CCHS-Melbourne/dingo-cap/v1.4.3d.back.png

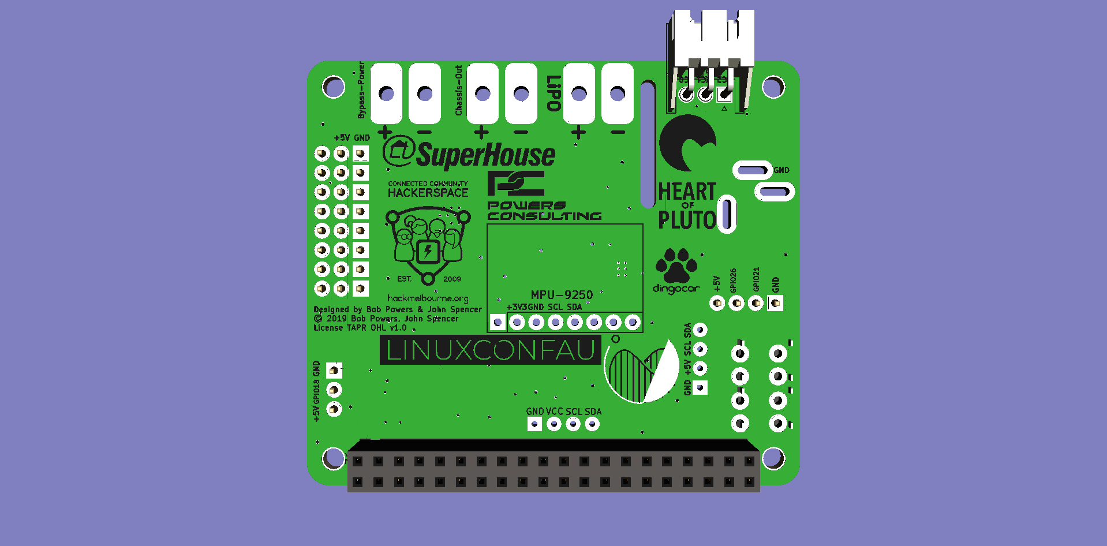
v1.4.3d.back.png
