CCHS-Melbourne/dingo-cap/v1.4.3d.front.png

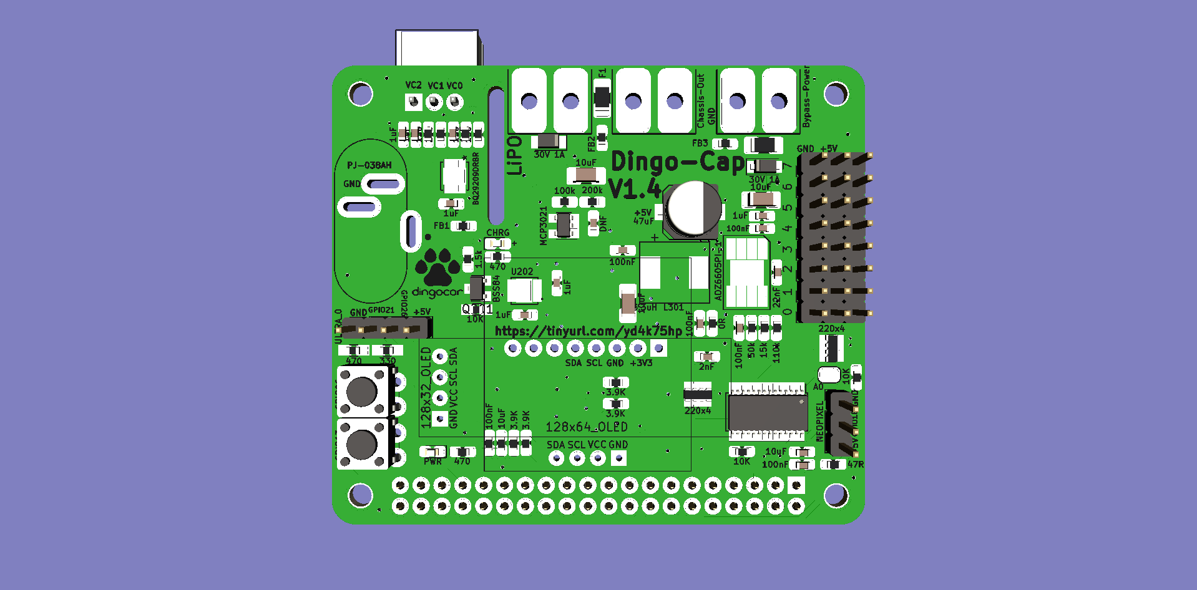
v1.4.3d.front.png
