CCHS-Melbourne/dingo-cap/Models/ElecCap.Panasonic.6.3 SIZE CODE D8.stp

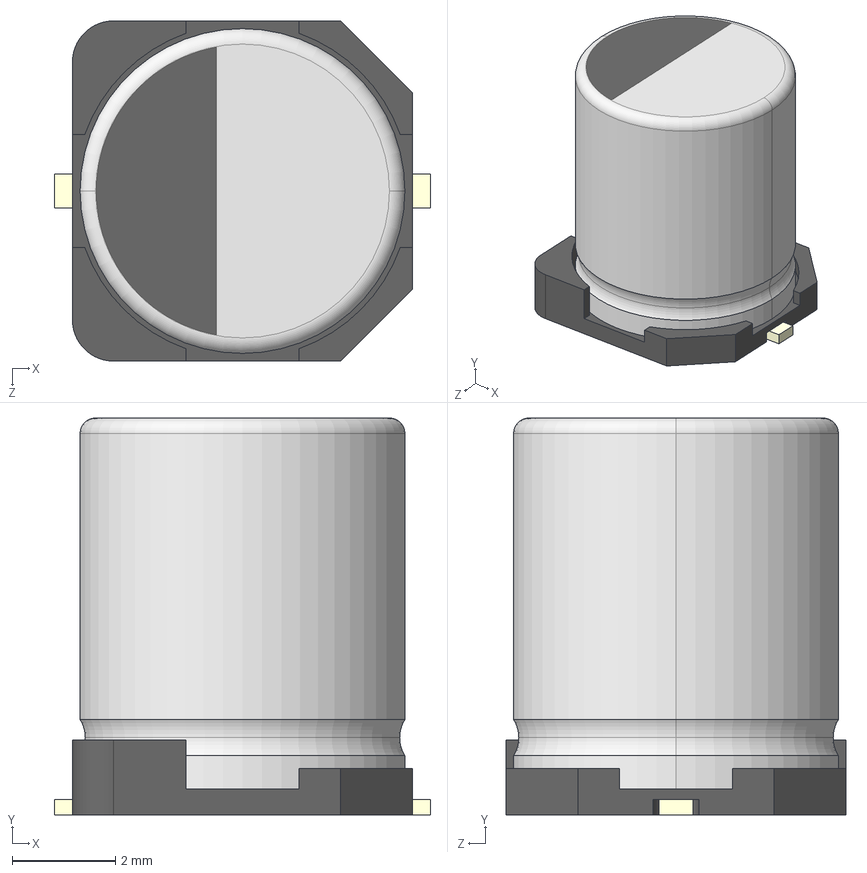
[picture p3: CAD file, 2019-10-31]
Models/ElecCap.Panasonic.6.3 SIZE CODE D8.stp
7.30 x 7.70 x 6.60 mm
標準SIZE CODE D8-001
標準SIZE CODE D8-002
標準SIZE CODE D8-003 x 2
