CCHS-Melbourne/dingo-cap/Models/Inductor.MPLCH0740L3R3.step

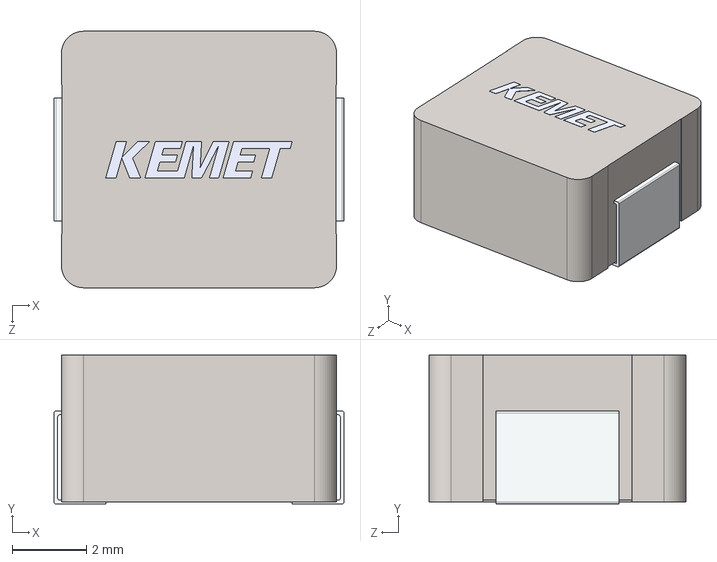
[picture p4: CAD file, 2019-10-31]
Models/Inductor.MPLCH0740L3R3.step
7.80 x 4.00 x 6.90 mm
