CCHS-Melbourne/dingo-cap/Models/ProtIC.SON60P300X60_HS-7N.step

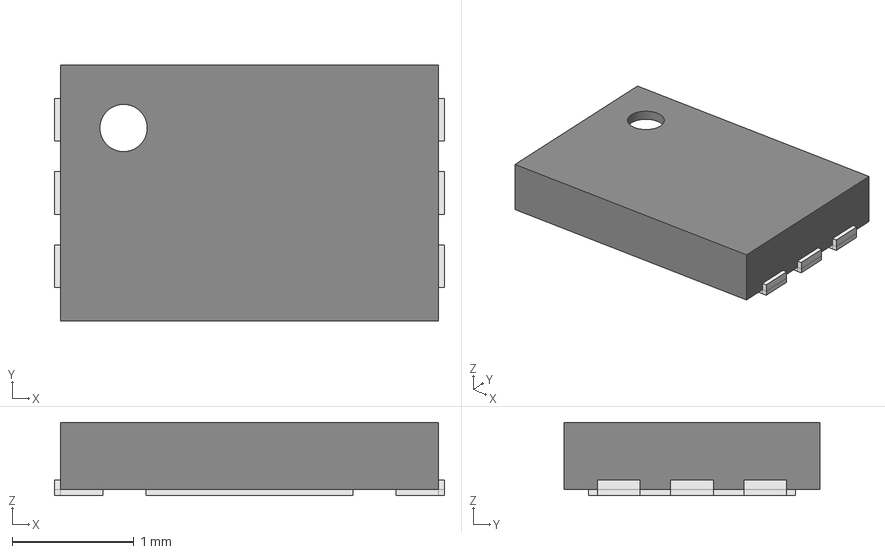
[picture p5: CAD file, 2019-10-31]
Models/ProtIC.SON60P300X60_HS-7N.step
3.20 x 2.10 x 0.6 mm
Open_CASCADE_STEP_translator_6.8_8.1
Open_CASCADE_STEP_translator_6.8_8.2.1
Thermal_Shape
Open_CASCADE_STEP_translator_6.8_8.4.1 x 6
