CCHS-Melbourne/dingo-cap/Models/DCDC.SOIC127P600-8N.step

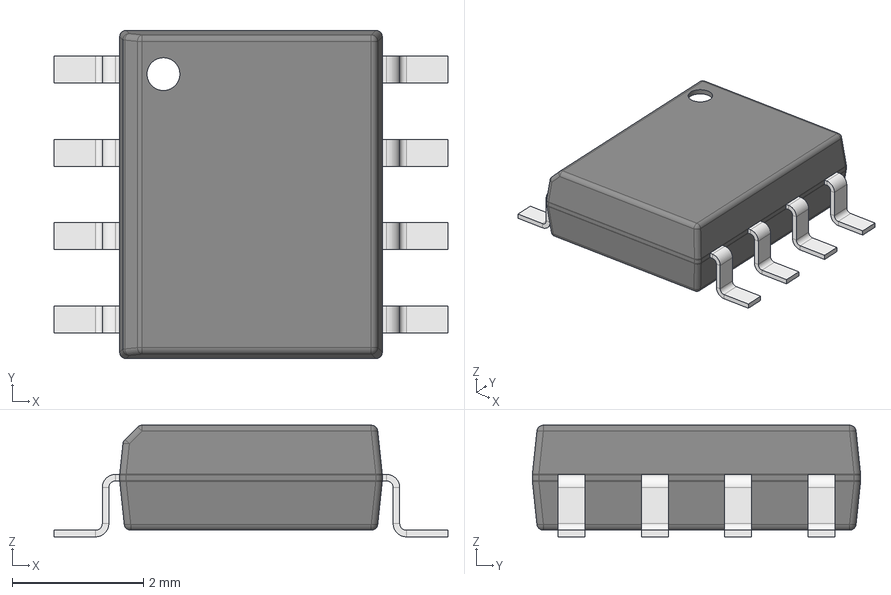
[picture p6: CAD file, 2019-10-31]
Models/DCDC.SOIC127P600-8N.step
6.00 x 5.00 x 1.70 mm
Open_CASCADE_STEP_translator_6.8_5.1
Open_CASCADE_STEP_translator_6.8_5.2.1
Leader x 8
