CCHS-Melbourne/dingo-cap/Models/Barrel.Jack.CUI_PJ-037B.step

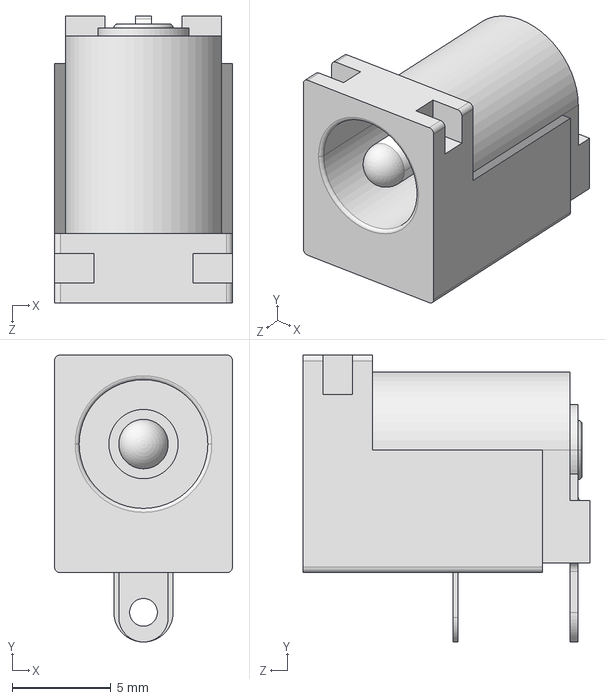
[picture p7: CAD file, 2019-10-31]
Models/Barrel.Jack.CUI_PJ-037B.step
9.00 x 14.5 x 14.5 mm
