CCHS-Melbourne/dingo-cap/pdf/dingo-hat.1.0.pdf

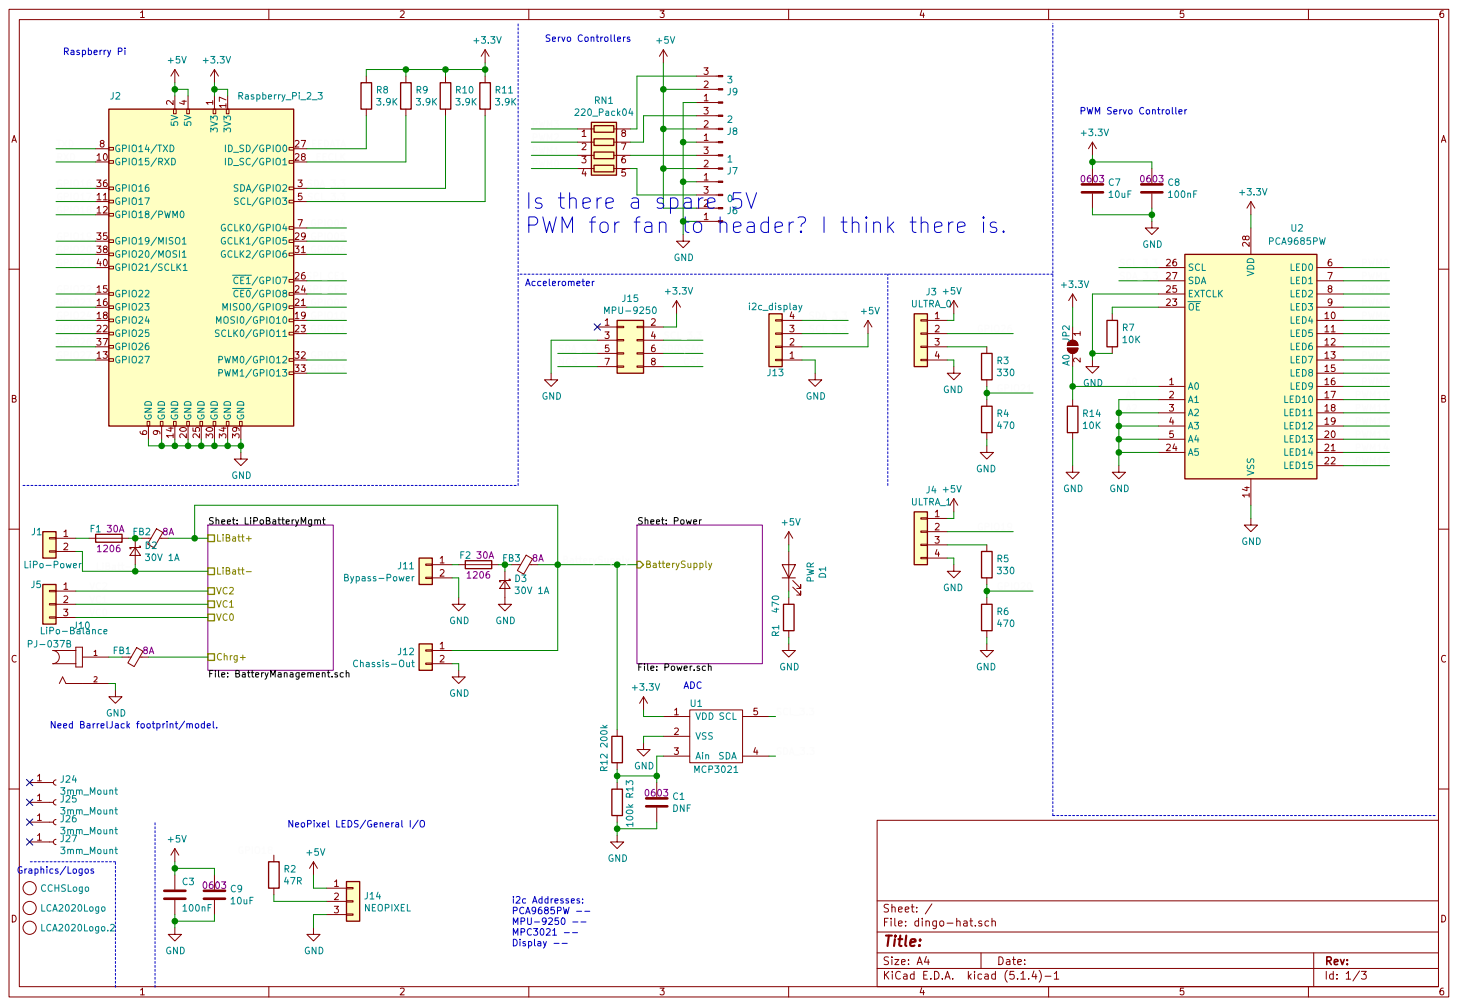
[picture p8: page 1]

File: dingo-hat.sch Sheet: / Sheet: Power File: Power.sch BatterySupply

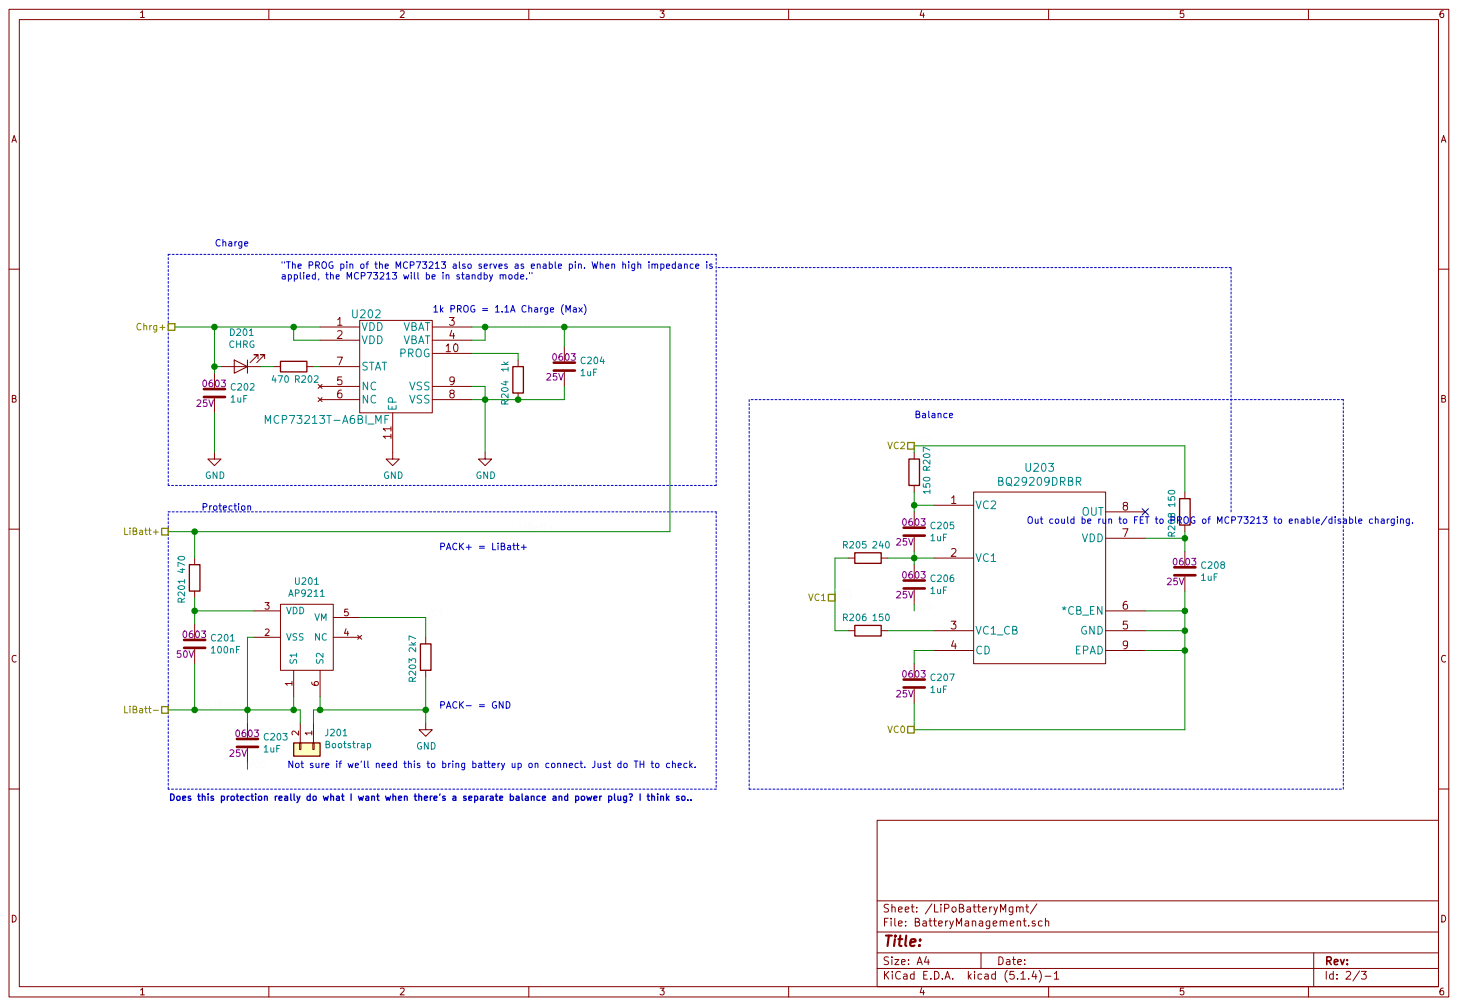
[picture p9: page 2]

"The PROG pin of the MCP73213 also serves as enable pin. When high impedance is
applied, the MCP73213 will be in standby mode."

LiBatt+

1 VSS 2 VDD 3 NC 4 VM 5 S2

Does this protection really do what I want when there's a separate balance and power plug? I think so.. PACK- = GND

Not sure if we'll need this to bring battery up on connect. Just do TH to check.

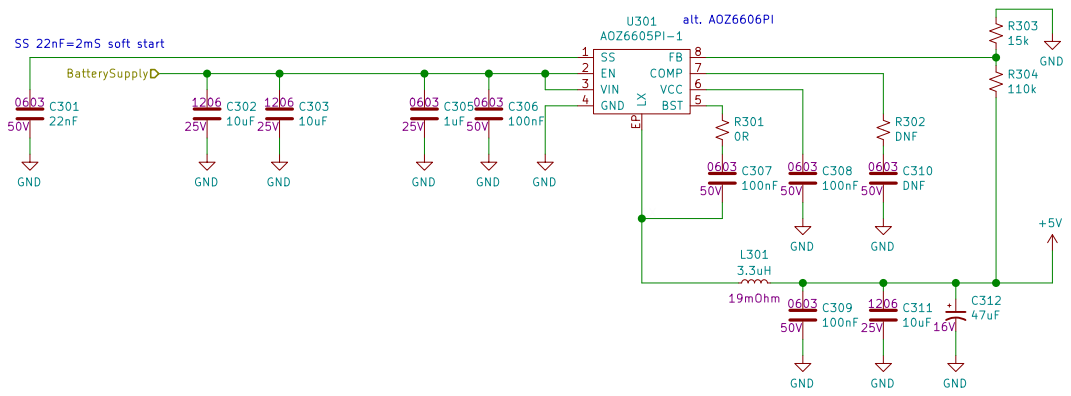
[picture p10: page 3]

alt. AOZ6606PI SS 22nF=2mS soft start

Id: 3/3 Title: File: Power.sch Sheet: /Power/ GND
