CCHS-Melbourne/dingo-cap/dingo-hat.kicad_pcb

## KiCad design dingo-hat.kicad_pcb (2019-12-08)

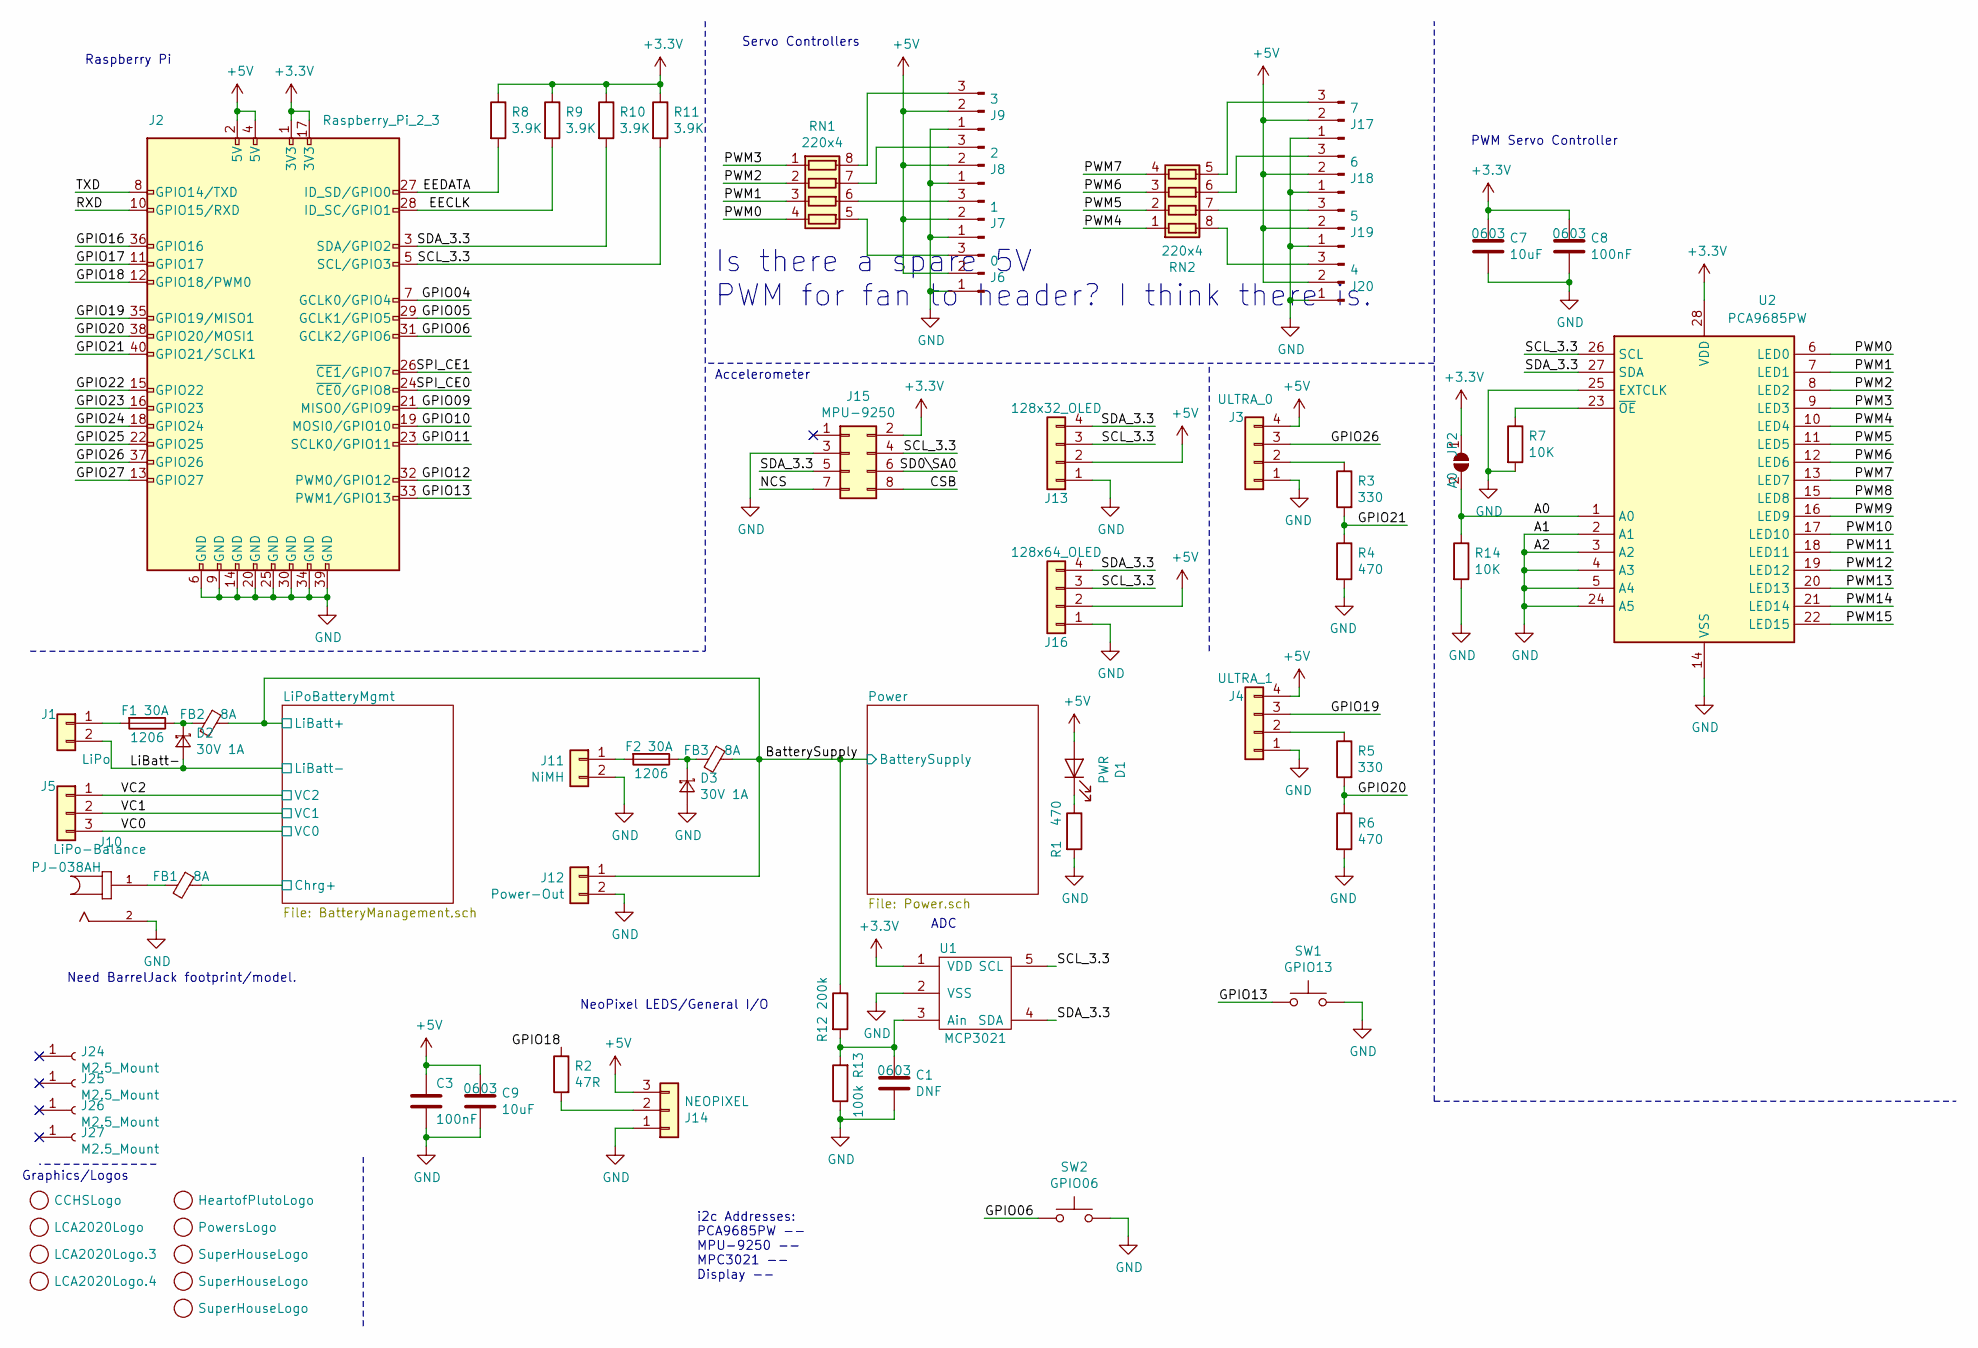
[picture p11: schematic dingo-hat.sch]

Parts:
C1: DNF; C_0603_1608Metric_Pad1.05x0.95mm_HandSolder; Voltage Rating 50V
C3: 100nF; R_0603_1608Metric_Pad1.05x0.95mm_HandSolder; Voltage Rating 50V
C7: 10uF; C_0603_1608Metric_Pad1.05x0.95mm_HandSolder
C8: 100nF; C_0603_1608Metric_Pad1.05x0.95mm_HandSolder; Voltage Rating 50V
C9: 10uF; R_0603_1608Metric_Pad1.05x0.95mm_HandSolder
D1: PWR; LED_0603_1608Metric_Pad1.05x0.95mm_HandSolder
D2, D3: 30V 1A; D_SOD-123F; Voltage Rating 30V
F1, F2: Fuse; R_1206_3216Metric_Pad1.42x1.75mm_HandSolder; Voltage Rating 32V
FB1, FB2, FB3: Ferrite_Bead_Small; R_0603_1608Metric_Pad1.05x0.95mm_HandSolder
G1: CCHSLogo; logo.cchs
G2: LCA2020Logo; logo.LCA.2020.1
G3: HeartofPlutoLogo; logo.HeartOfPluto2
G4: LCA2020Logo.3; logo-2020.silk
G5: LCA2020Logo.4; logo-2020.mask
G6: PowersLogo; logo.pc
G7: SuperHouseLogo; logo.superhouse
G8, G9: SuperHouseLogo; logo.dingocar
J1: LiPo; SolderWirePad_2x_5.08mm_14-18AWG-2mmDrill
J2: Raspberry_Pi_2_3; PinSocket_2x20_P2.54mm_Vertical
J3: ULTRA_0; Pin_Header_Straight_1x04_Pitch2.54mm
J4: ULTRA_1; Pin_Header_Straight_1x04_Pitch2.54mm
J5: LiPo-Balance; JST_XH_S03B-XH-A_03x2.50mm_Angled
J6: 0; PinHeader_1x03_P2.54mm_Vertical
J7: 1; PinHeader_1x03_P2.54mm_Vertical
J8: 2; PinHeader_1x03_P2.54mm_Vertical
J9: 3; PinHeader_1x03_P2.54mm_Vertical
J10: PJ-038AH; CUI_PJ-038AH; Mfg Part # PJ-038AH
J11: NiMH; SolderWirePad_2x_5.08mm_14-18AWG-2mmDrill
J12: Power-Out; SolderWirePad_2x_5.08mm_14-18AWG-2mmDrill
J13: 128x32_OLED; 0.91 OLED
J14: NEOPIXEL; PinHeader_1x03_P2.54mm_Vertical
J15: MPU-9250; PinHeader_1x08_P2.54mm_Vertical
J16: 128x64_OLED
J17: 7; PinHeader_1x03_P2.54mm_Vertical
J18: 6; PinHeader_1x03_P2.54mm_Vertical
J19: 5; PinHeader_1x03_P2.54mm_Vertical
J20: 4; PinHeader_1x03_P2.54mm_Vertical
J24, J25, J26, J27: M2.5_Mount; MountingHole_2.7mm_M2.5
JP2: A0; SolderJumper-2_P1.3mm_Open_RoundedPad1.0x1.5mm
R1: 470; R_0603_1608Metric_Pad1.05x0.95mm_HandSolder
R2: 47R; R_0603_1608Metric_Pad1.05x0.95mm_HandSolder
R3, R5: 330; R_0603_HandSoldering
R4, R6: 470; R_0603_HandSoldering
R7, R14: 10K; R_0603_1608Metric_Pad1.05x0.95mm_HandSolder
R8, R9, R10, R11: 3.9K; R_0603_1608Metric_Pad1.05x0.95mm_HandSolder
R12: 200k; R_0603_1608Metric_Pad1.05x0.95mm_HandSolder
R13: 100k; R_0603_1608Metric_Pad1.05x0.95mm_HandSolder
RN1, RN2: 220x4; R_Array_Convex_4x0603
SW1: GPIO13; SW_PUSH_4.5mm
SW2: GPIO06; SW_PUSH_4.5mm
U1: MCP3021; SOT-23-5; Mfg Part # MCP3021A5T-E/OT
U2: PCA9685PW; TSSOP-28_4.4x9.7mm_P0.65mm; Mfg Part # PCA9685

Connections:
+3V3: C7.1, C8.1, J2.1 (3V3), J2.17 (3V3), J15.2, JP2.1 (A), R8.1, R9.1, R10.1, R11.1, U1.1 (VDD), U2.28 (VDD)
+5V: C3.1, C9.1, D1.2 (A), J2.2 (5V), J2.4 (5V), J3.4, J4.4, J6.2, J7.2, J8.2, J9.2, J13.2, J14.3, J16.2, J17.2, J18.2, J19.2, J20.2; also elsewhere on the board
/A0: JP2.2 (B), R14.1, U2.1 (A0)
/BatterySupply: FB2.1, FB3.1, J12.1, R12.1; also elsewhere on the board
/CSB: J15.8
/EECLK: J2.28 (ID_SC/GPIO1), R9.2
/EEDATA: J2.27 (ID_SD/GPIO0), R8.2
/GPIO04: J2.7 (GCLK0/GPIO4)
/GPIO05: J2.29 (GCLK1/GPIO5)
/GPIO06: J2.31 (GCLK2/GPIO6), SW2.1
/GPIO09: J2.21 (MISO0/GPIO9)
/GPIO10: J2.19 (MOSI0/GPIO10)
/GPIO11: J2.23 (SCLK0/GPIO11)
/GPIO12: J2.32 (PWM0/GPIO12)
/GPIO13: J2.33 (PWM1/GPIO13), SW1.1
/GPIO16: J2.36 (GPIO16)
/GPIO17: J2.11 (GPIO17)
/GPIO18: J2.12 (GPIO18/PWM0), R2.1
/GPIO19: J2.35 (GPIO19/MISO1), J4.3
/GPIO20: J2.38 (GPIO20/MOSI1), R5.2, R6.1
/GPIO21: J2.40 (GPIO21/SCLK1), R3.2, R4.1
/GPIO22: J2.15 (GPIO22)
/GPIO23: J2.16 (GPIO23)
/GPIO24: J2.18 (GPIO24)
/GPIO25: J2.22 (GPIO25)
/GPIO26: J2.37 (GPIO26), J3.3
/GPIO27: J2.13 (GPIO27)
/LiPoBatteryMgmt/Chrg+: FB1.1; also elsewhere on the board
/NCS: J15.7
/PWM0: RN1.4 (R4.1), U2.6 (LED0)
/PWM1: RN1.3 (R3.1), U2.7 (LED1)
/PWM2: RN1.2 (R2.1), U2.8 (LED2)
/PWM3: RN1.1 (R1.1), U2.9 (LED3)
/PWM4: RN2.1 (R1.1), U2.10 (LED4)
/PWM5: RN2.2 (R2.1), U2.11 (LED5)
/PWM6: RN2.3 (R3.1), U2.12 (LED6)
/PWM7: RN2.4 (R4.1), U2.13 (LED7)
/PWM8: U2.15 (LED8)
/PWM9: U2.16 (LED9)
/PWM10: U2.17 (LED10)
/PWM11: U2.18 (LED11)
/PWM12: U2.19 (LED12)
/PWM13: U2.20 (LED13)
/PWM14: U2.21 (LED14)
/PWM15: U2.22 (LED15)
/RXD: J2.10 (GPIO15/RXD)
/SCL_3.3: J2.5 (SCL/GPIO3), J13.3, J15.4, J16.3, R11.2, U1.5 (SCL), U2.26 (SCL)
/SD0\SA0: J15.6
/SDA_3.3: J2.3 (SDA/GPIO2), J13.4, J15.5, J16.4, R10.2, U1.4 (SDA), U2.27 (SDA)
/SPI_CE0: J2.24 (~CE0~/GPIO8)
/SPI_CE1: J2.26 (~CE1~/GPIO7)
/TXD: J2.8 (GPIO14/TXD)
/VC0: J5.3; also elsewhere on the board
/VC1: J5.2; also elsewhere on the board
/VC2: J5.1; also elsewhere on the board
GND: C1.2, C3.2, C7.2, C8.2, C9.2, D2.2 (A), D3.2 (A), J1.2, J2.6 (GND), J2.9 (GND), J2.14 (GND), J2.20 (GND), J2.25 (GND), J2.30 (GND), J2.34 (GND), J2.39 (GND), J3.1, J4.1, J6.1, J7.1, J8.1, J9.1, J10.2, J11.2, J12.2, J13.1, J14.1, J15.3, J16.1, J17.1, J18.1, J19.1, J20.1, R1.2, R4.2, R6.2, R7.2, R13.1, R14.2, SW1.2, SW2.2, U1.2 (VSS), U2.2 (A1), U2.3 (A2), U2.4 (A3), U2.5 (A4), U2.14 (VSS), U2.24 (A5), U2.25 (EXTCLK); also elsewhere on the board
unnamed: C1.1, R12.2, R13.2, U1.3 (Ain)
unnamed: D1.1 (K), R1.1
unnamed: D2.1 (K), F1.1, FB2.2
unnamed: D3.1 (K), F2.1, FB3.2
unnamed: F1.2, J1.1
unnamed: F2.2, J11.1
unnamed: FB1.2, J10.1
unnamed: J3.2, R3.1
unnamed: J4.2, R5.1
unnamed: J6.3, RN1.5 (R4.2)
unnamed: J7.3, RN1.6 (R3.2)
unnamed: J8.3, RN1.7 (R2.2)
unnamed: J9.3, RN1.8 (R1.2)
unnamed: J14.2, R2.2
unnamed: J17.3, RN2.5 (R4.2)
unnamed: J18.3, RN2.6 (R3.2)
unnamed: J19.3, RN2.7 (R2.2)
unnamed: J20.3, RN2.8 (R1.2)
unnamed: R7.1, U2.23 (~OE)

Notes on the sheet:
PWM Servo Controller
NeoPixel LEDS/General I/O
Servo Controllers
Raspberry Pi
Accelerometer
Graphics/Logos
ADC
i2c Addresses: PCA9685PW -- MPU-9250 -- MPC3021 -- Display --
Need BarrelJack footprint/model.
Is there a spare 5V PWM for fan to header? I think there is.

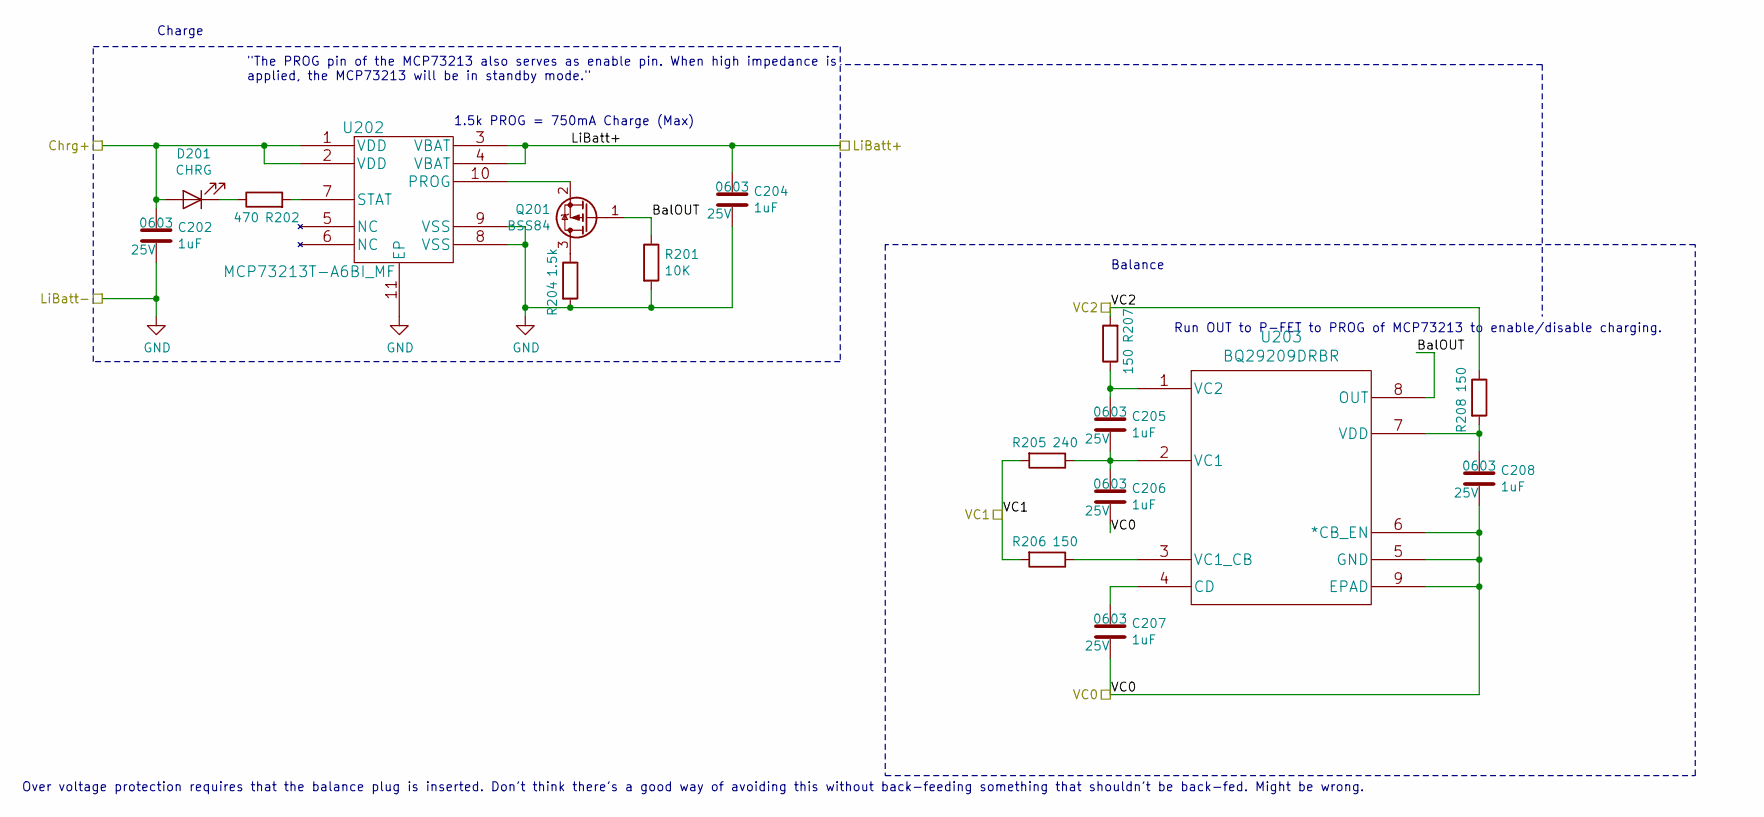
[picture p12: schematic BatteryManagement.sch]

Parts:
C202, C204, C205, C206, C207, C208: 1uF; C_0603_1608Metric_Pad1.05x0.95mm_HandSolder; Voltage Rating 25V
D201: CHRG; LED_0603_1608Metric_Pad1.05x0.95mm_HandSolder
Q201: BSS84; SOT-23
R201: 10K; R_0603_HandSoldering
R202: 470; R_0603_1608Metric_Pad1.05x0.95mm_HandSolder
R204: 1.5k; R_0603_1608Metric_Pad1.05x0.95mm_HandSolder
R205: 240; R_0603_1608Metric_Pad1.05x0.95mm_HandSolder
R206, R207, R208: 150; R_0603_1608Metric_Pad1.05x0.95mm_HandSolder
U202: MCP73213T-A6BI_MF; MCP73213T-A6BI
U203: BQ29209DRBR; Mfg Part # BQ29209DRBR

Connections:
/BatterySupply: C204.1, U202.3 (VBAT), U202.4 (VBAT); also elsewhere on the board
/LiPoBatteryMgmt/BalOUT: Q201.1 (G), R201.1, U203.8 (OUT)
/LiPoBatteryMgmt/Chrg+: C202.1, D201.2 (A), U202.1 (VDD), U202.2 (VDD); also elsewhere on the board
/VC0: C206.2, C207.2, C208.2, U203.5 (GND), U203.6 (*CB_EN), U203.9 (EPAD); also elsewhere on the board
/VC1: R205.2, R206.2; also elsewhere on the board
/VC2: R207.2, R208.1; also elsewhere on the board
GND: C202.2, C204.2, R201.2, R204.2, U202.8 (VSS), U202.9 (VSS), U202.11 (EP); also elsewhere on the board
unnamed: C205.1, R207.1, U203.1 (VC2)
unnamed: C205.2, C206.1, R205.1, U203.2 (VC1)
unnamed: C207.1, U203.4 (CD)
unnamed: C208.1, R208.2, U203.7 (VDD)
unnamed: D201.1 (K), R202.1
unnamed: Q201.2 (S), U202.10 (PROG)
unnamed: Q201.3 (D), R204.1
unnamed: R202.2, U202.7 (STAT)
unnamed: R206.1, U203.3 (VC1_CB)

Notes on the sheet:
1.5k PROG = 750mA Charge (Max)
Run OUT to P-FET to PROG of MCP73213 to enable/disable charging.
Balance
Charge
"The PROG pin of the MCP73213 also serves as enable pin. When high impedance is applied, the MCP73213 will be in standby mode."
Over voltage protection requires that the balance plug is inserted. Don't think there's a good way of avoiding this without back-feeding something that shouldn't be back-fed. Might be wrong.

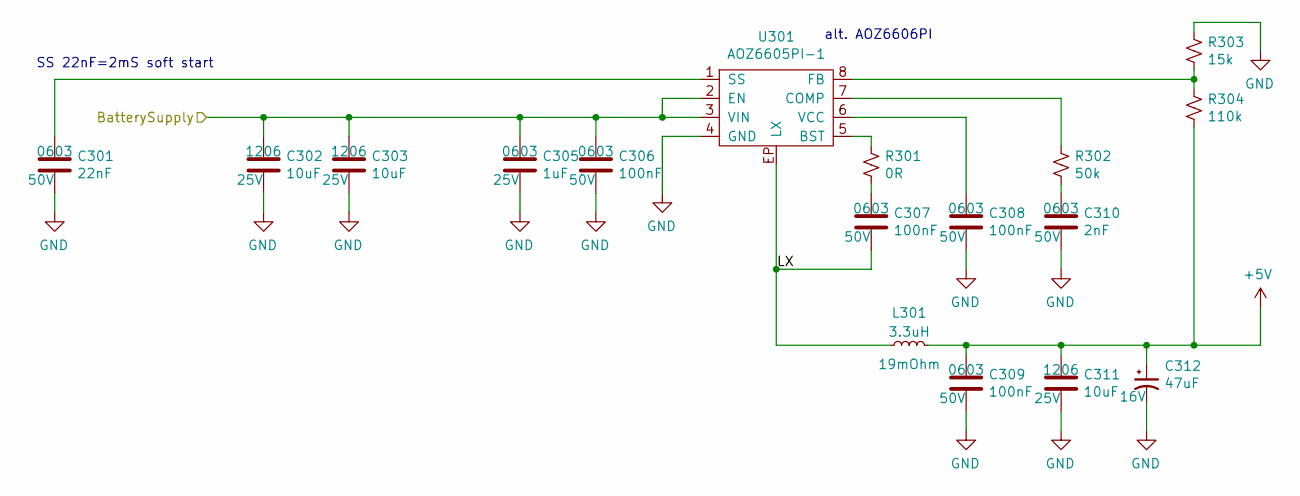
[picture p13: schematic Power.sch]

Parts:
C301: 22nF; C_0603_1608Metric_Pad1.05x0.95mm_HandSolder; Voltage Rating 50V
C302, C303, C311: 10uF; C_1206_3216Metric_Pad1.42x1.75mm_HandSolder; Voltage Rating 25V
C305: 1uF; C_0603_1608Metric_Pad1.05x0.95mm_HandSolder; Voltage Rating 25V
C306, C307, C308, C309: 100nF; C_0603_1608Metric_Pad1.05x0.95mm_HandSolder; Voltage Rating 50V
C310: 2nF; C_0603_1608Metric_Pad1.05x0.95mm_HandSolder; Voltage Rating 50V
C312: 47uF; CP_Elec_6.6x6.6; Voltage Rating 16V
L301: 3.3uH; Inductor-SMT-MPLCH0740
R301: 0R; R_0603_1608Metric_Pad1.05x0.95mm_HandSolder
R302: 50k; R_0603_1608Metric_Pad1.05x0.95mm_HandSolder
R303: 15k; R_0603_1608Metric_Pad1.05x0.95mm_HandSolder
R304: 110k; R_0603_1608Metric_Pad1.05x0.95mm_HandSolder
U301: AOZ6605PI-1; SOIC-8-EP--AOZ6605PI-1; Mfg Part # AOZ6605PI-1

Connections:
+5V: C309.1, C311.1, C312.1, L301.2, R304.2; also elsewhere on the board
/BatterySupply: C302.1, C303.1, C305.1, C306.1, U301.2 (EN), U301.3 (VIN); also elsewhere on the board
/Power/LX: C307.2, L301.1, U301.EP (LX)
GND: C301.2, C302.2, C303.2, C305.2, C306.2, C308.2, C309.2, C310.2, C311.2, C312.2, R303.1, U301.4 (GND); also elsewhere on the board
unnamed: C301.1, U301.1 (SS)
unnamed: C307.1, R301.1
unnamed: C308.1, U301.6 (VCC)
unnamed: C310.1, R302.1
unnamed: R301.2, U301.5 (BST)
unnamed: R302.2, U301.7 (COMP)
unnamed: R303.2, R304.1, U301.8 (FB)

Notes on the sheet:
alt. AOZ6606PI
SS 22nF=2mS soft start

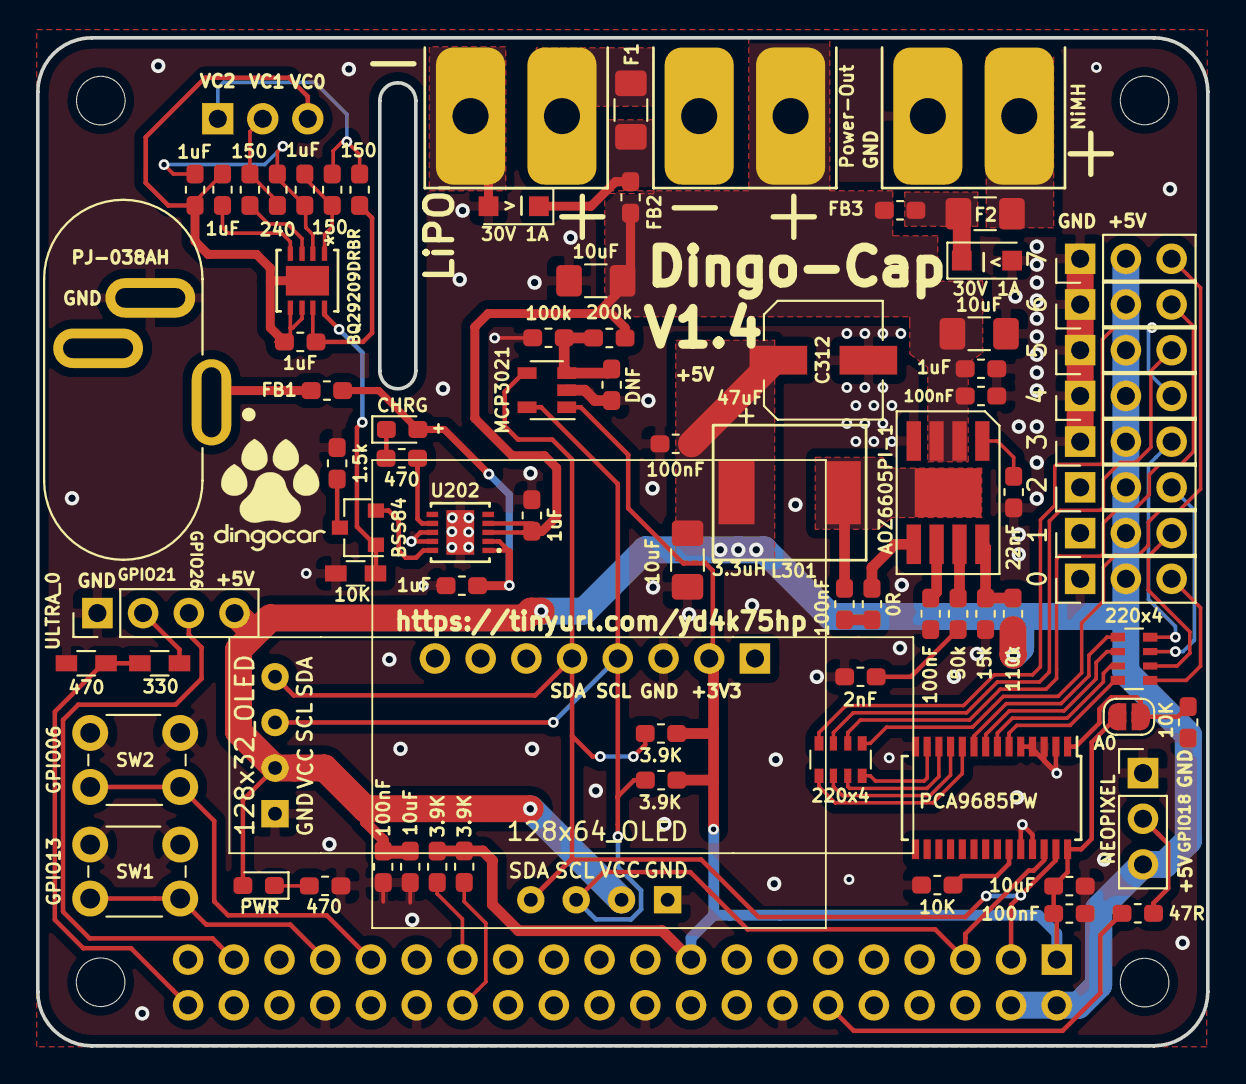
[picture p14: board dingo-hat.kicad_pcb from above]

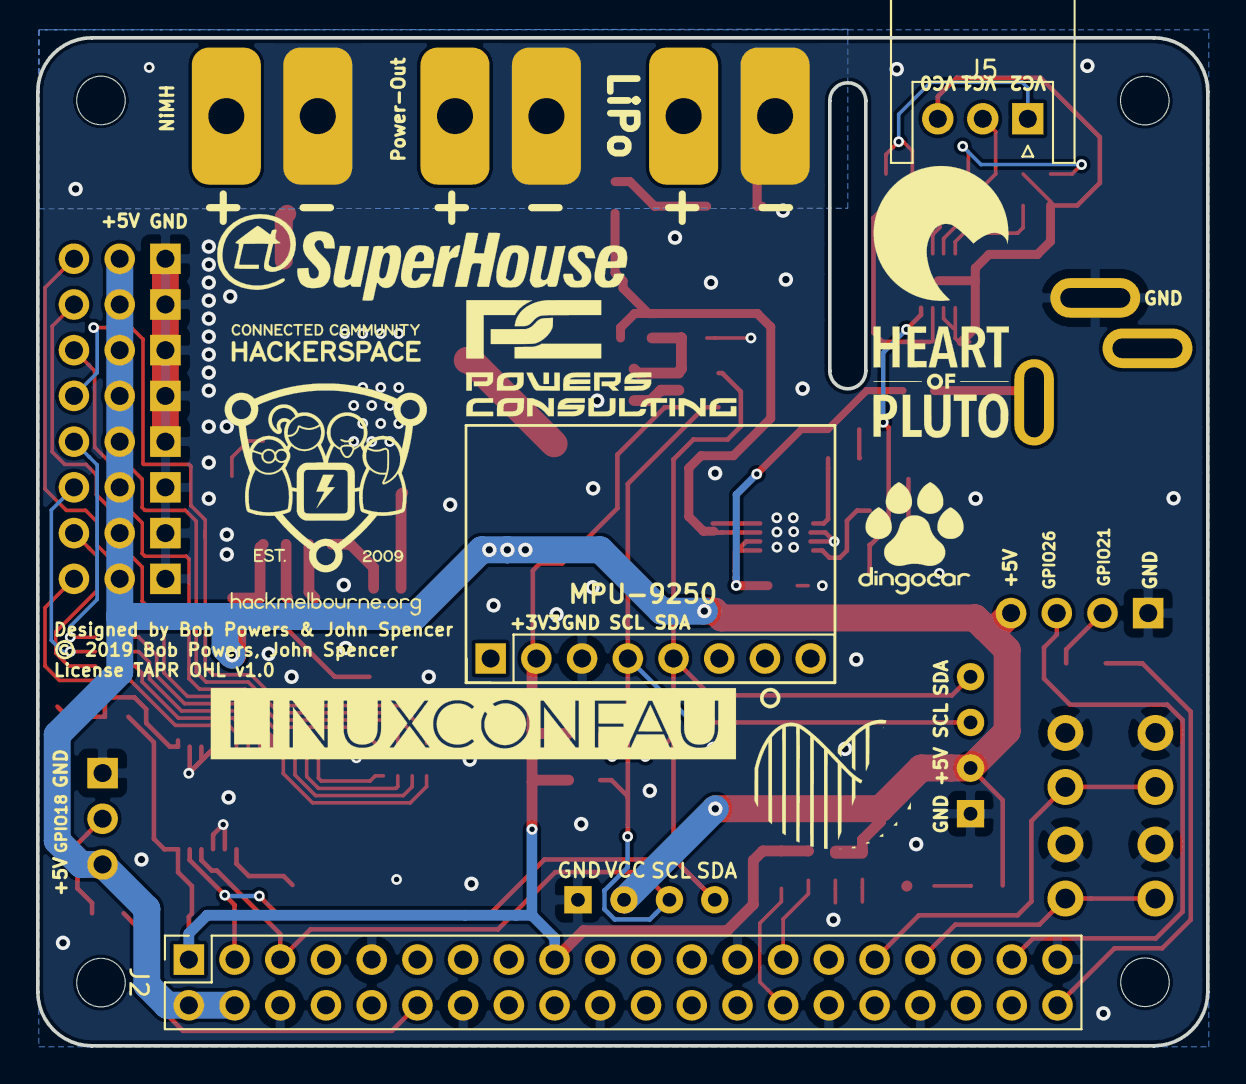
[picture p15: board dingo-hat.kicad_pcb from below]

Board: 2 copper layers, 65.0 x 56.0 mm, 98 parts (11 on the bottom side), 62 nets.
