CCHS-Melbourne/dingo-cap/(commit log)

2019-10-17 Cleaning up libs. Looking at power.
    [Power.sch, dingo-hat.kicad_pcb, dingo-hat.sch]
2019-10-19 Setting up fields, more structure, touching up schematic display properties.
    [BatteryManagement.sch, Power.sch, dingo-hat.kicad_pcb, dingo-hat.sch]
2019-10-19 Decisions on DCDC, adding components.
    [Power.sch]
2019-10-23 Doing schematic of DCDC.
    [Power.sch]
2019-10-23 Starting battery protection & management.
    [BatteryManagement.sch, Power.sch]
2019-10-23 Changing structure, RM old power circuitry.
    [BatteryManagement.sch, Power.sch, dingo-hat.sch]
2019-10-24 Battery work, need to get on to connectors.
    [BatteryManagement.sch, Power.sch, dingo-hat.sch]
2019-10-24 Charging. Do balance next if including.
    [BatteryManagement.sch, Power.sch, dingo-hat.sch]
2019-10-25 Balance IC lib & footprint.
    [BatteryManagement.sch]
2019-10-25 Battery circuitry nearly done. Look at charge enable.
    [BatteryManagement.sch]
2019-10-25 Adding ADC for battery level.
    [BatteryManagement.sch, dingo-hat.sch]
2019-10-25 Getting rid of address block on PCA9685. We don't need that many options.
    [Power.sch, dingo-hat.sch]
2019-10-25 Create 0.91 OLED.kicad_mod
    Footprint for the 0.91 OLED we plan to use.
2019-10-26 Removed 4 of the Servo pins
    We only need 4.
    [BatteryManagement.sch, Power.sch, dingo-hat.sch]
2019-10-26 Added i2c header
    [dingo-hat.sch]
2019-10-29 Placeholders for some connectors.
    [BatteryManagement.sch, Power.sch, dingo-hat.sch]
2019-10-29 Cleaning up some nets, adding input caps on power.
    [BatteryManagement.sch, Power.sch, dingo-hat.sch]
2019-10-29 Changing net names on balance charger.
    [BatteryManagement.sch]
2019-10-29 Self notes.
    [BatteryManagement.sch]
2019-10-31 Power protection.
    [BatteryManagement.sch, Power.sch, dingo-hat.sch]
2019-10-31 Filling in some footprints, cleaning up schematic.
    [BatteryManagement.sch, Power.sch, dingo-hat.sch]
2019-10-31 Adding barrel jack, models.
    [Barrel.Jack.CUI_PJ-037B.step, DCDC.SOIC127P600-8N.step, ElecCap.Panasonic.6.3 SIZE CODE D8.stp, Inductor.MPLCH0740L3R3.step, ProtIC.SON60P300X60_HS-7N.step, dingo-hat.kicad_pcb, dingo-hat.sch]
2019-10-31 Cleaning up schematics.
    [BatteryManagement.sch, dingo-hat.sch]
2019-10-31 Chaging lib table. Going to push sch to pcb.
2019-10-31 Cleaning up the component links.
    [BatteryManagement.sch, dingo-hat.sch]
2019-10-31 Doing some back and forth on initial placements. Remove address options for PWM.
    [dingo-hat.kicad_pcb, dingo-hat.sch]
2019-10-31 Trying out layout, modifying solder pad footprint.
    [BatteryManagement.sch, dingo-hat.kicad_pcb, dingo-hat.sch]
2019-10-31 Some blocks of layout.
    [dingo-hat.kicad_pcb]
2019-10-31 Pushing and shoving components.
    [Power.sch, dingo-hat.kicad_pcb]
2019-10-31 Just moving that PWM controller back from the edge.
    [dingo-hat.kicad_pcb]
2019-10-31 Updated logos
    Updated the CCHS logo and added a new one for Linux.conf.au 2020
    [dingo-hat.kicad_pcb]
2019-10-31 Updated for the logo.
    [dingo-hat.sch]
2019-11-01 Compacting blocks of layout.
    [BatteryManagement.sch, dingo-hat.kicad_pcb]
2019-11-01 Starting power fills.
    [dingo-hat.kicad_pcb]
2019-11-01 Power net fill routing.
    [Power.sch, dingo-hat.kicad_pcb, dingo-hat.sch]
2019-11-01 Pushing things around. Routing. Major current paths done.
    [dingo-hat.kicad_pcb]
2019-11-01 Needs cleaning up, but most routing done.
    [BatteryManagement.sch, dingo-hat.kicad_pcb, dingo-hat.sch]
2019-11-03 Updated Silkscreen.
    [dingo-hat.kicad_pcb]
2019-11-03 Minor tweaks to overlay.
    [dingo-hat.kicad_pcb]
2019-11-04 Adding top pour to balance CU. Gerbers.
    [dingo-hat-B_Cu.gbl, dingo-hat-B_Mask.gbs, dingo-hat-B_Paste.gbp, dingo-hat-B_SilkS.gbo, dingo-hat-Edge_Cuts.gm1, dingo-hat-F_Cu.gtl, dingo-hat-F_Mask.gts, dingo-hat-F_Paste.gtp]
2019-11-05 This should be the prototype production version v1.0. Tag HERE.
    [dingo-hat-B_Cu.gbl, dingo-hat-B_Mask.gbs, dingo-hat-B_Paste.gbp, dingo-hat-B_SilkS.gbo, dingo-hat-Edge_Cuts.gm1, dingo-hat-F_Cu.gtl, dingo-hat-F_Mask.gts, dingo-hat-F_Paste.gtp]
2019-11-05 Moving everything so origin is at an round point.
    [dingo-hat.kicad_pcb]
2019-11-05 Removing errant astrisk on U202. Closes #2.
    [dingo-hat.kicad_pcb]
2019-11-06 Updated footprints
    [dingo-hat.kicad_pcb]
2019-11-06 Changed and re-routed to be 2 layer
    [dingo-hat-B_Cu.gbl, dingo-hat-B_Mask.gbs, dingo-hat-B_Paste.gbp, dingo-hat-B_SilkS.gbo, dingo-hat-F_Cu.gtl, dingo-hat-F_Mask.gts, dingo-hat-F_Paste.gtp, dingo-hat-F_SilkS.gto]
2019-11-15 updated footprints to handsolder
    [BatteryManagement.sch, Power.sch, dingo-hat.kicad_pcb, dingo-hat.sch]
2019-11-20 Included both oled and MPU on top. Additional silkscreen designs
    [dingo-hat.kicad_pcb, dingo-hat.sch]
2019-11-22 Updated silkscreen. Added button
    [dingo-hat.kicad_pcb, dingo-hat.sch]
2019-11-23 Minor updates to hopefully make soldering easier.
    [dingo-hat.kicad_pcb]
2019-11-25 Changing MCP73213 footprint to recommended dimensions. Need to update board to close issue.
2019-11-26 Tweaks to footprint alignment.
    [dingo-hat-B_Cu.gbl, dingo-hat-B_Mask.gbs, dingo-hat-B_Paste.gbp, dingo-hat-B_SilkS.gbo, dingo-hat-F_Cu.gtl, dingo-hat-F_Mask.gts, dingo-hat-F_Paste.gtp, dingo-hat-F_SilkS.gto]
2019-11-26 New V.1.2 gerbers
    [dingo-hat-B_Cu.gbl, dingo-hat-B_Mask.gbs, dingo-hat-B_Paste.gbp, dingo-hat-B_SilkS.gbo, dingo-hat-F_Cu.gtl, dingo-hat-F_Mask.gts, dingo-hat-F_Paste.gtp, dingo-hat-F_SilkS.gto]
2019-11-27 Updating loop compensation values with asperational attempt.
    [Power.sch, dingo-hat.kicad_pcb]
2019-11-27 Fixing glitch in 6-UDFN footprint.
2019-11-27 Fixing up Li protection IC, update some fills. Relief on protection IC.
    [dingo-hat.kicad_pcb]
2019-11-27 Closes #19 - MCP footprint already updated. Adding calcs spreadsheet referenced in Issue #14.
    [AOZ6605PI-1.Calcs.ods, dingo-hat.kicad_pcb]
2019-11-27 Direct pad connect rear GND power pads.
    [dingo-hat.kicad_pcb]
2019-12-02 Remove the LiPo OC protection, fuse & RP will be sufficient when used with balance & charge OV cutoff. That change is in here too. Closes #17, closes #22.
    [BatteryManagement.sch]
2019-12-02 Changing barrel jack to be 2.1ID, 5.5OD. Needs double check to close issue (28).
    [BatteryManagement.sch, dingo-hat.kicad_pcb, dingo-hat.sch]
2019-12-05 Change mounting holes to M2.5. Closes #29.
    [dingo-hat.kicad_pcb, dingo-hat.sch]
2019-12-05 Cleaning up, flipped JST balance. Closes #21.
    [dingo-hat.kicad_pcb]
2019-12-05 Added second header for OLED referenced in #25, need to place. Added model for barrel jack - may not be perfectly aligned.
    [dingo-hat.kicad_pcb, dingo-hat.sch]
2019-12-05 Flipping around the PWM header, making room for moving DC/DC.
    [dingo-hat.kicad_pcb]
2019-12-05 Ripping up, re-placing lots of stuff to make more room.
    [dingo-hat.kicad_pcb]
2019-12-05 Smushing everything left to make room for that electrolytic as mentioned in #24
    [dingo-hat.kicad_pcb]
2019-12-05 More compacting, improvement on space utilization. Closes #24.
    [dingo-hat.kicad_pcb]
2019-12-06 Flipping IMU to back of board.
    [Power.sch, dingo-hat.kicad_pcb]
2019-12-07 IMU now properly flipped.
    [dingo-hat.kicad_pcb]
2019-12-07 Trying to add in the ultrasonics, other bits.
    [BatteryManagement.sch, dingo-hat.kicad_pcb, dingo-hat.sch]
2019-12-07 Maybe just re-layout the whole thing.
    [dingo-hat.kicad_pcb]
2019-12-07 Compactifying the balance circuit, making heaps of space.
    [dingo-hat.kicad_pcb]
2019-12-07 Most things in place, thinking about adding power button, other buttons.
    [dingo-hat.kicad_pcb]
2019-12-07 Routed with dual oled
    Single Ultrasonic has made it back. Yay!
    [dingo-hat.kicad_pcb, dingo-hat.sch]
2019-12-07 Added logos
    [dingo-hat-B_Cu.gbl, dingo-hat-B_Mask.gbs, dingo-hat-B_Paste.gbp, dingo-hat-B_SilkS.gbo, dingo-hat-F_Cu.gtl, dingo-hat-F_Mask.gts, dingo-hat-F_Paste.gtp, dingo-hat-F_SilkS.gto]
2019-12-08 Added 4 extra PWM. Reroute.
    Also flipped design to be up the right way for our chassis.
    [dingo-hat.kicad_pcb, dingo-hat.sch]
2019-12-08 Generated Gerbers for 1.4 version
    [dingo-hat-B_Cu.gbl, dingo-hat-B_Mask.gbs, dingo-hat-B_Paste.gbp, dingo-hat-B_SilkS.gbo, dingo-hat-F_Cu.gtl, dingo-hat-F_Mask.gts, dingo-hat-F_Paste.gtp, dingo-hat-F_SilkS.gto]
2019-12-08 Changing labels, adding vias, tweaking.
    [dingo-hat.kicad_pcb, dingo-hat.sch]
2019-12-08 More minor tweaks. Nearly done.
    [dingo-hat.kicad_pcb]
2019-12-08 Minor updates to overlays.
    [dingo-hat.kicad_pcb]
2019-12-08 Candidate v1.4 production files.
    [dingo-hat-B_Cu.gbl, dingo-hat-B_Mask.gbs, dingo-hat-B_Paste.gbp, dingo-hat-B_SilkS.gbo, dingo-hat-F_Cu.gtl, dingo-hat-F_Mask.gts, dingo-hat-F_Paste.gtp, dingo-hat-F_SilkS.gto]
2019-12-09 Regenerating gerbers candidate v1.4.
    [dingo-hat-B_Cu.gbl, dingo-hat-B_Mask.gbs, dingo-hat-B_Paste.gbp, dingo-hat-B_SilkS.gbo, dingo-hat-F_Cu.gtl, dingo-hat-F_Mask.gts, dingo-hat-F_Paste.gtp, dingo-hat-F_SilkS.gto]
