CCHS-Melbourne/dingo-cap/(notices)

Notices in the files:
dingo-hat.kicad_pcb:
© 2019 Bob Powers, John Spencer
parts and their libraries:
Copyright 2016 Accelerated Designs. All rights reserved.
